hao-yue-1/SmartCar/README.md

# SmartCar
第十七届全国大学生智能车竞赛-四轮摄像头组

@autor: 

-   图像、控制、结构：**吴滨楠**、**刘骏帆**，

-   电路：**钟锐城**
