hao-yue-1/SmartCar/Seekfree_TC264_Opensource_Library/修改日志.md

# 2021/12/8 WBN

- main.c
  - 添加变量定义，修改格式
