hao-yue-1/SmartCar/(list of files, drawings)

Other design files:
Hardware/宝宝主板_V7/宝宝主板_V7.PrjPcb
Hardware/宝宝主板_V7/宝宝主板_V7.SchDoc
Hardware/宝宝驱动板_V8/宝宝驱动板_V8.PrjPcb
Hardware/宝宝驱动板_V8/宝宝驱动板_V8.SchDoc
