hao-yue-1/SmartCar/Seekfree_TC264_Opensource_Library/CODE/Motor.c

/*
 * Motor.c
 *
 *  Created on: 2021年12月19日
 *      Author: yue
 */

#include "Motor.h"
#include "Filter.h"         //滤波
#include <stdio.h>
#include "PID.h"            //PID
#include "SEEKFREE_18TFT.h"
#include "LED.h"

void Stop(void);

int16 speed_l,speed_r;      //电机左右速度目标值的全局变量
uint8 encoder_dis_flag=2;   //编码器测距flag（赋初值=2，避免自己开启检测导致int溢出）

/*
*********************************************************************************************************
** 函 数 名: MotorSetPWM
** 功能说明: 控制左右电机的转速与正反转
** 形    参: left_speed：赋值给左电机的转速
**           right_speed：赋值给电机的转速
** 返 回 值: 无
*********************************************************************************************************
*/
void MotorSetPWM(int pwm_l,int pwm_r)
{
    //限幅处理
    if(pwm_l>MOTOR_PWM_MAX)
        pwm_l=MOTOR_PWM_MAX;
    else if(pwm_l<-MOTOR_PWM_MAX)
        pwm_l=-MOTOR_PWM_MAX;
    if(pwm_r>MOTOR_PWM_MAX)
        pwm_r=MOTOR_PWM_MAX;
    else if(pwm_r<-MOTOR_PWM_MAX)
        pwm_r=-MOTOR_PWM_MAX;
    //判断电机的正反转并进行速度赋值
    //下面是逐飞驱动板，使用一个IO口控制正反转，一个IO口输出PWM的控制方式
//    if(pwm_l>=0)   //左电机正转
//    {
//        gpio_set(P02_6,0);
//        pwm_duty(LEFT_MOTOR_PIN1,pwm_l);
//    }
//    else                //左电机反转
//    {
//        gpio_set(P02_6,1);
//        pwm_duty(LEFT_MOTOR_PIN1,-pwm_l);
//    }
//    if(pwm_r>=0)  //右电机正转
//    {
//        gpio_set(P02_7,0);
//        pwm_duty(RIGHT_MOTOR_PIN1,pwm_r);
//    }
//    else                //右电机反转
//    {
//        gpio_set(P02_7,1);
//        pwm_duty(RIGHT_MOTOR_PIN1,-pwm_r);
//    }

    //下面是自制驱动板，使用两个PWM信号驱动一个电机的驱动方法
    //左电机
    if(pwm_l>=0)   //正转
    {
        pwm_duty(LEFT_MOTOR_PIN1,pwm_l);
        pwm_duty(LEFT_MOTOR_PIN2,0);
    }
    else                //反转
    {
        pwm_duty(LEFT_MOTOR_PIN1,0);
        pwm_duty(LEFT_MOTOR_PIN2,-pwm_l);
    }
    //右电机
    if(pwm_r>=0)  //正转
    {
        pwm_duty(RIGHT_MOTOR_PIN1,0);
        pwm_duty(RIGHT_MOTOR_PIN2,pwm_r);
    }
    else                //反转
    {
        pwm_duty(RIGHT_MOTOR_PIN1,-pwm_r);
        pwm_duty(RIGHT_MOTOR_PIN2,0);
    }
}

/*
*********************************************************************************************************
** 函 数 名: MotorEncoder
** 功能说明: 读取左右电机的编码器的值
** 形    参: left_encoder：左电机编码器的值
**           right_encoder：右电机编码器的值
** 返 回 值: 无
** 注    意：由于编码器相对放置，向前运动时对右编码器取反处理
*********************************************************************************************************
*/
void MotorEncoder(int16* left_encoder,int16* right_encoder)
{
    //左编码器
    *left_encoder = gpt12_get(LEFT_ENCODER);
    gpt12_clear(LEFT_ENCODER);
    //右编码器
    *right_encoder = -gpt12_get(RIGHT_ENCODER);
    gpt12_clear(RIGHT_ENCODER);
}

/*
*********************************************************************************************************
** 函 数 名: MotorCtrl
** 功能说明: 使用增量式PI控制器控制左右电机转速
** 形    参: speed_l：左电机速度
**           speed_r：右电机速度
** 返 回 值: 无
*********************************************************************************************************
*/
void MotorCtrl(int16 speed_l,int16 speed_r)
{
    int16 encoder_l=0,encoder_r=0;   //左右电机编码器值
    int pwm_l=0,pwm_r=0;             //左右电机PWM

    MotorEncoder(&encoder_l,&encoder_r);              //获取左右电机编码器
    encoder_l=SecondOrderLagFilter_L(encoder_l);      //低通滤波
    encoder_r=SecondOrderLagFilter_R(encoder_r);
    pwm_l=Speed_PI_Left(encoder_l,speed_l,MotorK_L);    //左右电机PID
    pwm_r=Speed_PI_Right(encoder_r,speed_r,MotorK_R);

    MotorSetPWM(pwm_l,pwm_r);                   //电机PWM赋值
    EncoderDistance(0,0,encoder_l,encoder_r);   //采集编码器值，用于编码器测距

//    //VOFA上位机调试
//    printf("%d,%d\n",encoder_l,encoder_r);  //发送左右编码器
}

/*
*********************************************************************************************************
** 函 数 名: MotorSetTarget
** 功能说明: 设置左右电机速度的目标值
** 形    参: target_l：左电机速度目标值
**           target_r：右电机速度目标值
** 返 回 值: 无
*********************************************************************************************************
*/
void MotorSetTarget(int16 target_l,int16 target_r)
{
    //速度限幅
    if(target_l>base_speed+SPEED_LIMIT)
    {
        target_l=base_speed+SPEED_LIMIT;
    }
    else if(target_l<base_speed-SPEED_LIMIT)
    {
        target_l=base_speed-SPEED_LIMIT;
    }
    if(target_r>base_speed+SPEED_LIMIT)
    {
        target_r=base_speed+SPEED_LIMIT;
    }
    else if(target_r<base_speed-SPEED_LIMIT)
    {
        target_r=base_speed-SPEED_LIMIT;
    }
    //速度赋值
    speed_l=target_l;
    speed_r=target_r;
}

/*
*********************************************************************************************************
** 函 数 名: EncoderDistance
** 功能说明: 编码器测距，该函数将在编码器中断中被调用于采集编码器的值（flag=0）；
**           在主进程中被调用于设置目标距离和开启检测，开启后需要用户手动查询encoder_dis_flag==1?
**           从而检测是否达到目标值
** 形    参: flag：选择函数功能（0：采集数据；1：测距模式；2：停车模式）
**           dis：目标距离，单位m（只有flag=1、2时，此项才起作用）
**           encoder_l：左编码器值（只有flag=0时，此项才起作用）
**           encoder_r：右编码器值（只有flag=0时，此项才起作用）
** 返 回 值: 无
*********************************************************************************************************
*/
void EncoderDistance(uint8 flag,float target_dis,int16 encoder_l,int16 encoder_r)
{
    static int encoder_nowsum=0,encoder_target=0;   //当前值和目标值
    static int stop_nowsum=0,stop_target=0;         //停车模式
    static uint8 encoder_stop_flag=0;               //停车flag

    if(flag==0) //采集数据
    {
        int16 encoder=(encoder_l+encoder_r)/2;  //左右编码器均值
        if(encoder_dis_flag==0) //测距模式
        {
            encoder_nowsum+=encoder;                //编码器累加
            if(encoder_nowsum>encoder_target)       //当前编码器超过目标值
            {
                encoder_dis_flag=1; //编码器测距flag置1
            }
        }
        if(encoder_stop_flag==1)//停车模式
        {
            stop_nowsum+=encoder;                   //编码器累加
            if(stop_nowsum>stop_target)             //当前编码器超过目标值
            {
                Stop(); //停车
            }
        }
    }
    else if(flag==1)     //测距模式
    {
        encoder_target=11731*target_dis;    //根据目标距离计算目标编码器值
        encoder_nowsum=0;                   //清空编码器累积值
        encoder_dis_flag=0;                 //编码器测距flag置0，开启编码器采集
    }
    else if(flag==2)    //停车模式
    {
        stop_target=11731*target_dis;
        stop_nowsum=0;
        encoder_stop_flag=1;    //开启定距停车
    }
}
