hao-yue-1/SmartCar/Seekfree_TC264_Opensource_Library/CODE/LED.h

/*
 * LED.h
 *
 *  Created on: 2022年5月23日
 *      Author: yue
 */

#ifndef CODE_LED_H_
#define CODE_LED_H_

//主控板LED颜色定义
#define LED_RED         P23_1
#define LED_YELLOW      P22_1
#define LED_WHITE       P22_2
#define LED_BLUE        P22_3
#define LED_GREEN       P21_2

void LEDInit(void);

#endif /* CODE_LED_H_ */
