hao-yue-1/SmartCar/Seekfree_TC264_Opensource_Library/CODE/Attitude.h

//
// Created by yue on 2022/5/11.
//

#ifndef ICM20602_ATTITUDE_H
#define ICM20602_ATTITUDE_H

#include "common.h"

typedef struct{ //四元数
    float q0;
    float q1;
    float q2;
    float q3;
}quaterInfo_t;

typedef struct{ //欧拉角
    float pitch;
    float roll;
    float yaw;
}eulerianAngles_t;

typedef struct  //陀螺仪校准值
{
    int16 x;
    int16 y;
    int16 z;
}GyroOffset;

extern float values[6];
extern eulerianAngles_t eulerAngle;

void GyroOffsetInit(void);
void IMUGetValues(float * values);
void IMU_quaterToEulerianAngles(void);

#endif //ICM20602_ATTITUDE_H
