hao-yue-1/SmartCar/(commit log)

2021-12-08 修改main.c添加了变量定义
2021-12-09 LJF测试了一下上次本地修改
2021-12-09 修改了MD文档
2021-12-09 新增Steer.c/.h舵机控制
2021-12-09 修改舵机引脚宏定义
2021-12-09 新增扫线到赛道外的判断
2021-12-10 添加PID文件（里面啥都没），添加对中线丢失的记录
2021-12-10 新增丢线记录
2021-12-10 LJF修改了一些小问题，比如舵机引脚在函数里面没改，和二维数组的访问不小心写错
2021-12-10 LJF把黑白代表的0和255改为宏定义，修改了二值化和扫线那里
2021-12-11 修改了主函数里面的摄像头图像交互模式
2021-12-11 使用了逐飞库的18TFT修改了cpu0_main
2021-12-19 添加了电机控制Motor.c/.h
2021-12-19 修改舵机中值与左右打死值
2021-12-22 添加了最小二乘法拟合回归方程求斜率
2021-12-23 修改了main
2021-12-23 修改了回归方程，发现之前的代码中，用于计算的X和Y搞反了，并且返回的是斜率倒数也就是误差，而不是斜率了，误差的正负代表了方向具体正负代表左右看舵机
2021-12-23 PID控制的初步编写，只有粗略的舵机位置式PID和舵机PID结构体的定义，疑惑的地方写在注释里面了
2021-12-26 添加了编码器在motor，PID中加入了对电机的增量式PI控制
2021-12-26 main中添加编码器的初始化
2022-01-16 回归方程求斜率的分子带错公式了，可能是因为修改别人代码的时候修改完求和那里没有修改下面
2022-01-16 发现分母也没改过来跟Z小璇的是一样但是他行列对应的XY是搞反了的
2022-01-17 增加了寻找左右下拐点的函数，拐点结构体，以及修改了一下扫线，让右边丢线的右线数组值赋值到最右边，便于找拐点，并且在数学上也合理
2022-01-17 添加了ImageSpecial文件，用于存放赛道特殊元素的判断，并在其中添加了起跑线识别函数，完成基本逻辑的编写
2022-01-18 增加了根据左右下拐点找寻三岔的上拐点
2022-01-18 IDE的配置文件而已
2022-01-18 新增两点之间的补线函数
2022-01-18 起跑线识别的收尾工作，并写了环岛识别的初始想法
2022-01-19 增加了三岔判断函数
2022-01-19 修改了一下找左右拐点的函数，并不是找数组的最大最小，而是变化的点
2022-01-19 补充环岛识别的代码，稍微修改一些变量和宏
2022-01-20 两种环岛入口识别的方法
2022-01-23 模糊PID的雏形写完了，还欠缺三个参数的实际论域的大小以及偏差实际论域大小，后期调参还是要先调好传统PID，再引入模糊PID，然后再去调节它的规则表,隶属度计算函数不知道是否有错误，使用的是三角形隶属度函数
2022-01-23 修改起跑线识别，主要是封装形式
2022-01-23 添加了查找上拐点函数
2022-01-29 修改扫线函数，并在main中测试了扫线函数
2022-02-06 修改二值化，扫线，将图像原点放回左上角
2022-02-07 测试一下赛道元素识别
2022-02-21 根据图像原点仍然在左上角检查了斜率函数，发现道理还是一样的，没有进行修改，只修改了返回时分子为0时即：倒数为无穷，所以返回tan89°的值
2022-02-22 增加谷底最小值算法，以及在赛道上测试了扫线函数效果不错，(下午4点谷底最小值有用，五点大津法好用，综上光线好用大津法不好用谷底),测试拐点函数时出错，程序卡死，或者找不到拐点无反应，已撤回下午修改部分
2022-02-24 修改了寻找左右下拐点的函数，starline>endline还是从下往上遍历数组
2022-02-24 修改了斜率函数，把矩阵模拟到第四象限，做了些许改变，尚未验证
2022-02-24 修改了寻找左右下拐点函数，并且验证成功，在赛道上成功找出左拐点并在LCD上显示
2022-02-25 修改了三岔上拐点的寻找，并且验证了上拐点的搜寻，修改了bug，bug的原因是由于图像原点修改回去了左上，但是代码没有得到相应修改
2022-02-25 修改了main.c文件，测试拐点给WBN看，同时找到了偶尔卡死的原因，就是别把描点的点放大
2022-02-25 修改了环岛识别并验证，修改扫线误差bug
2022-02-26 整理一下工程代码规范，测试斜率函数，修改了前瞻长度，因为早上光线大，所以人为把阈值加了20
2022-02-26 实现环岛入口的补线，修改补线函数
2022-02-26 添加了一个二值化算法
2022-02-27 测试了新的二值化方法
2022-02-27 完善环岛入口的判断
2022-02-27 修改了一下左右下拐点和三岔上拐点函数函数开始置零拐点，测试了三岔识别函数成功，修改了补线函数，K应该为浮点型否则精度缺失为0，指针索引应该为int所以添加了强制类型转化
2022-02-28 修改新加的二值化阈值计算的bug（还没测试）
2022-03-06 写了PID初始化函数，配合主控板修改了电机驱动引脚
2022-03-06 修改重定向的串口，改为蓝牙串口，串口2
2022-03-06 测试了电机驱动，编码器，和PI速度环
2022-03-06 “周日下午写完了蓝牙发送数据和蓝牙接收，使用串口2中断回调函数进行”
2022-03-07 蓝牙发送斜率偏差函数的编写，采集斜率的赛道数据得知，偏差一般为4.6左右测试的时候前瞻取的是整个屏幕中间的三分之一，尝试往前再取一点
2022-03-07 修改了下舵机PD控制，返回了-PWM+舵机中值的处理，但是PWM是无符号的，所以KP不能超过一个数字，估计为765/5
2022-03-09 蓝牙串口中断接收添加一些注释
2022-03-10 优化串口中断蓝牙接收数据代码
2022-03-13 增加了十字的识别，修改了寻找左右下拐点的函数（从下往上如果找到了就不再进行判断）,WBN修改了扫线时候丢线给的值为最大边界-1为了lcd不卡死，也修改了他的圆环条件-1
2022-03-13 修改了舵机pid
2022-03-13 十字和三岔一起进行判断，解决了三岔误判的情况，条件就是，三岔的左右拐点往上不会太快丢线
2022-03-13 增加了十字判断方法，正入情况和斜入情况都有
2022-03-13 修改识别十字函数
2022-03-14 添加新的电机驱动，添加新的求Bias，修改舵机PID
2022-03-15 修改PID、补线
2022-03-17 把三线设置为全局变量，extern在ImageBasic.h文件中，修改了三岔识别和十字识别函数，在识别完类型之后就进行补线
2022-03-18 修改了十字和三岔的误判，修了一下图像，三岔上顶点加了条件，车基本动了起来，直线很摆，可能偏差函数有问题，D加一点就不会超调
2022-03-18 添加滤波算法，添加舵机的PID算法，修改PID结构体
2022-03-18 修改了编码器的滤波滤去了十分大的尖峰和很小的个位数值，逐飞编码器返回的是定时器寄存器的值，所以放在轮询中会使得时间周期不统一而不是一个速度是位移
2022-03-18 速度环还是坏的，加i就超调到起飞，然后本来成功过一次，下午BN摆烂完把编码器放中断的时候，后面就寄了，9点开始调转向环成就不大，建议多去理论分析一下
2022-03-19 pid的参数修改为浮点型，在三个pid函数里面增加了计算pwm的时候强制类型转化为int
2022-03-19 解决速度环PID的BUG，注：先开驱动板再开主控板，防止主控板误判编码器的值累积PID误差
2022-03-19 微调速度环PID（没啥用）
2022-03-20 添加了野火上位机的通信协议，修改并添加了PID和MOTOR的全局变量
2022-03-20 添加停止电机的选项
2022-03-21 添加野火PID调试助手通信协议，添加环岛入口识别（静态验证，存在较多误判）
2022-03-21 添加了环岛入口的判断（仅环岛在左侧的情况），已低速验证不会存在误判
2022-03-22 舵机控制放在了中断中，舵机PWM设为全局变量，舵机PID值换成了上周那个，速度还是只有50,50走的真的很好，接下来可能要分段才能提速了
2022-03-23 把蓝牙调参的相关修改全删除，蓝牙串口回调函数
2022-03-23 在蓝牙串口中断中加入野火上位机的数据接收
2022-03-24 添加了三岔识别，如果左右拐点不存在，并且第一行就开始丢线的情况也去寻找上拐点存不存在，修改电机限幅为8300
2022-03-24 修改了电机PID的一个小问题
2022-03-25 修改了三岔左右怪点消失，只有V型的BUG，不以最下面一行丢线，而是倒数第十行否则会和普通弯道误判，不知道为什么；找拐点的时候左右遍历更远一点；初始化画面左右下角为补线点的时候，Y应该是最大的而不是0；三擦汗上顶点判断存在加上了Y因为X最开始就赋值了所以X一定存在；存在问题：顶点找到了但是可能补线有问题，还没解决，去开会了
2022-03-25 添加了车库识别，还没验证
2022-03-25 修改了无法补线问题：参数传错了，删除了调试用的代码，以及修改了一个小bug寻找V点的时候宏定义穿错了传成H了，改为W
2022-03-26 添加了环岛识别的整体函数，将Bias修改为全局变量，删除之前自己写的查找上拐点的函数
2022-03-26 重写了环岛识别
2022-03-27 验证新的环岛识别，出环岛还未完善
2022-03-27 完善环岛状态机，修改其中状态二的机制，除三岔S道外无其他误判
2022-03-28 添加编码器的滤波并调整了速度环PI，对环岛状态二的跳转加限制条件
2022-03-28 周日修改的三岔现在上传，做出的调整是在三岔补线之后就进行偏差计算，不在外面进行计算了，减少了一个上拐点存在的条件增快速度，验证良好
2022-03-28 修改了补线函数，让人为选择补左还是右
2022-03-29 添加了图像总处理的逻辑函数，目的是得到Bias给中断去控制
2022-03-29 修改了补线函数的bug
2022-03-29 修改了扫线的bug：120-1，修改了十字的bug，X改为Y
2022-03-30 完善环岛，主要是环岛中部的判断和进环岛后给一个补偿偏差
2022-03-30 完善三岔和十字，更新舵机PD为纯P
2022-04-02 修改了三岔和十字
2022-04-02 修改环岛状态机，修改元素判断优先级
2022-04-03 更新了逐飞的封装库
2022-04-04 没什么动作，但还是同步一下
2022-04-06 速度提到100，舵机P加了0.25，计算偏差加了个判断点是不是白点，否则不要，二维数组访问可能很慢，我认为可以在扫线加上标志位，环岛可能识别不到出口
2022-04-07 修改环岛状态机机制，修改图像处理中环岛的flag为静态变量
2022-04-07 添加了Bias计算后真值的判断，调试起跑线（还没完成）
2022-04-08 修改识别起跑线函数（未验证）
2022-04-09 修改了前几天出现的十字在圆环里面误判的bug，还未验证
2022-04-09 把斜入十字的判断删除，经常会判断为斜入，但是到时候又不会，BIAS如果遍历到黑点就break
2022-04-10 斜入的情况还是要判断的，但是不做出反应
2022-04-10 十字在弯道的误判修改了，加了个二值化图像滤波作用一般需要改进，入圆环那个弯会误判成3的十字最好修改一下，用sobel测试了一下，几个flag变成全局变量用于蓝牙查看
2022-04-11 修改电机驱动模块
2022-04-11 修改程序到可以完整跑一圈
2022-04-12 添加了按键检测模块，并在CPU0中初始化
2022-04-13 昨晚：修改PID和速度环
2022-04-13 放弃环岛修改的程序，修改了舵机D并添加滤波
2022-04-13 删掉一些不相干的东西，包括protocol中的点灯和之前写的十字回环
2022-04-14 添加右环岛状态机，修改两个环岛的函数定义，并修改目标速度为90、转向环PID
2022-04-15 添加十字回环出口的判断
2022-04-15 修改右环岛出口识别的bug
2022-04-15 修改了十字回环出口的BUG，并添加赛道的状态机
2022-04-15 修改三岔识别，将十字回环识别分为两个，添加入库
2022-04-15 完善状态机
2022-04-16 Bias再分一段加权，速度提到100
2022-04-16 加入差速转向，添加若干宏定义
2022-04-16 添加左库斑马线，和三岔修改
2022-04-16 添加十字入环判断
2022-04-16 添加了三岔函数的状态机，这样能够判断三岔结束
2022-04-16 完善整个赛道的状态机，修改识别十字回环入口的bug
2022-04-16 修改入库bug，降低速度90
2022-04-17 添加了第二个十字回环入口补线
2022-04-17 修改了斑马线左边
2022-04-17 90跑完一圈
2022-04-17 调了下左车库，100很虚，95比较稳
2022-04-17 添加出库，速度分段
2022-04-17 添加了左库识别状态机，一帧延迟防误判，速度能上105
2022-04-17 修改三岔状态机
2022-04-17 完善状态机，修改差速限幅
2022-04-17 第一个十字回环120，第二个十字回环也提速了，然后入第二个十字回环的时候D减小差速增大
2022-04-17 修改环岛状态机和十字回环出口
2022-04-17 烧板前还能跑的程序，把左环岛速度提高100，但是好像不是很稳定，出十字回环出口加了减速并调大差速，作用也不是很明显
2022-04-17 在1核中添加按键调，设定S5为退出调参，S1~S4具体功能未定
2022-04-18 完善按键调参的内容（未验证）
2022-04-18 添加按键调参，完善并验证
2022-04-18 修改十字回环
2022-04-18 取消分段控制参数的注释
2022-04-18 关闭了TFT，左车库上升到120，三岔上升到130，十字回环125，回来125，之前的D和差速全都删去了
2022-04-18 第一个十字回环上升到135比较稳定，但是怕出来会碰到路肩
2022-04-18 修改左环岛状态机，进行提速
2022-04-18 修改右环岛状态机，提速
2022-04-18 完善状态机，速度到了但不够稳定
2022-04-19 没调啥，左库车速从120上升到130，进第一次三岔降速成125比较稳定，出两个十字回环打死的延迟降低了100ms，现在基本125是能稳定完赛的
2022-04-19 把三岔判断还是改回去了，注意现在是在三岔调试模式，状态四开始
2022-04-20 左环速度提升到130，速度环PID的I从1.2降低到1
2022-04-20 添加卡尔曼滤波（没有用到），修改差速阈值
2022-04-20 1.72m的程序，三岔识别有问题，状态机出不去，准备放宽状态机先放宽状态机看看稳不稳定，再放宽三岔识别提速，左库前面的弯道加差速加速
2022-04-21 三岔状态机改变，速度上升到135感觉还能升，左库有危险
2022-04-21 速度环添加D，修改按键
2022-04-21 添加三岔状态机，提高第二个十字回环出来的速度
2022-04-21 完善环岛状态机，添加出环岛补线，约束左环岛出环条件
2022-04-22 修改十字回环减速方案，右边可行版本
2022-04-22 微调左环岛路径方案，出库提到150，上次push中添加了按键修改分段状态
2022-04-22 修改速度环PID
2022-04-23 三岔加长延时帧，三岔速度从130提到140，150也成功过，但是不知道后面为什么不行了，而且成功了好几遍，车体很抖
2022-04-23 从第二个十字回环里面出来加个延迟，之后再进行三岔判断，否则s弯中间会误判
2022-04-23 降低第二个十字速度，在三岔中提速
2022-04-24 1.78m，但是入库超出去了
2022-04-24 三岔的加速放后一点
2022-04-25 补线增加了特殊情况，三岔丢失左右下拐点那一帧bias*1.5，入第一次三岔速度提到160，但是没全程跑一遍
2022-04-25 添加环岛补线
2022-04-25 第二次入三岔的速度从150提到160,准备写个三岔正入跟随拐点行数去缩放bias的操作
2022-04-25 修改摄像头帧数，修改各部分延时对应，修改第二个十字回环出环速度
2022-04-25 大幅提速，25.3秒
2022-04-26 之前修改的摄像头帧数忘记上传
2022-04-26 修改左环岛状态机，入环不减速，两个十字回环入环速度提高
2022-04-26 调了下入库，发现根本不是入不了库，的被路肩弹开
2022-04-26 左环岛和左车库提速
2022-04-26 第一个三岔从155提速到165
2022-04-26 验证了十字回环回来，识别到三岔出口的减速少5，入库识别到打死前加10ms延时，入三岔中间之后KD从5减小到3
2022-04-26 出第一个十字回环延时减小
2022-04-27 添加阿克曼差速，修改舵机参数，修改右环岛补线，修改入库
2022-04-27 修改第二个十字回环入口补线
2022-04-27 修改第二个十字回环出环，修改速度
2022-05-16 修改车模机械结构，重新调整舵机中值等数据和阿克曼打角
2022-05-18 添加ICM20602模块和相应的姿态解算，其中yaw并不理想需要改进
2022-05-19 添加陀螺仪Z轴角度积分
2022-05-19 八领域写了左线寻找，打印出来看看效果如何，还没对八领域到的拐点进行处理
2022-05-21 找回十字识别，粗略写了十字的状态机，但是入十字途中的画面没写，后续再加一个新的找拐点函数
2022-05-23 补充之前ICM的遗漏，重新封装了一下LED和KEY
2022-05-24 修改了LED灯对应引脚的宏定义，完善了十字识别，现在补线补的还不错，左右斜入也OK了，但是发现了个问题，找拐点函数好像有问题，不动它一会坐标找得到一会找不到
2022-05-24 十字状态机调试，陀螺仪辅助出环还不错，但是不能完全转到270再识别出口要差不多270的时候就应该去识别出口了，识别出口只识别了一帧可能有点草率，打算再加点，ICM地址改为接地
2022-05-24 “简单优化一下之前的姿态解算 git commit -m“简单优化一下之前的姿态解算
2022-05-24 “改一下注释 git commit -m“改一下注释
2022-05-25 修改文件架构，把每个元素识别相关的源代码分开各自的源文件中，但是头文件还是一个special.h，已经分开了十字三岔车库
2022-05-25 修改图像识别函数.c文件的封装
2022-05-25 升级了一下补线函数，因为还没测试所以是另写了个V2新函数，如果验证还不错之后，可能会考虑替代掉之前的函数
2022-05-26 把入十字中的状态也写成一个else if写入十字识别中
2022-05-27 找拐点函数寻找的怪点更加精确了
2022-05-27 十字识别修改，改了下正入的判断，以及入十字中间，还有那个识别的else return 0纯纯编译器骗人
2022-05-28 添加陀螺仪零漂修复
2022-05-28 修改速度环为两个套参数
2022-05-28 十字微调，正入找上拐点的函数避免因为拐点处乱七八糟，起始点从拐点行的-5行增加到了-15行，斜入十字的条件增加了一边的丢线要小于一半，状态机有TFT和无TFT，以及出状态普通巡线均测试过，没问题，就是出状态的时候是十字中间，注意不要跟其他元素误判,出三岔那里会误判十字，下次再细看一下
2022-05-29 修改舵机PID和中值
2022-05-29 重写了左库识别函数，以及左库状态机，完善了左库入库或不入库都有，缺陷在于，斜率的放缩是盲调的，比如入库我觉得我补线也补的还行，但是它打角了我就缩小了点，然后丢失左拐点的时候补线会补的极端点，ICM判断入库，如果一开始角度不好很容易寄，后续考虑加上图像一起判断一下
2022-06-01 添加了寻找上拐点的函数，还没测试，有LCDdebug的代码在里面，一去工一马上就能看出行不行问题在哪，用法是找到下拐点之后根据下拐点给起始行
2022-06-01 调整环岛状态机
2022-06-02 修改舵机PID
2022-06-03 从上往下遍历左右线来找直角上拐点，起始行要小于结束行，在VS2019OPENCV中测试过能顺利运行只需要调试那两个宏定义即可
2022-06-03 把正入十字，以及左库的上拐点换成了新写的搜寻上拐点函数
2022-06-04 修改出环和入环
2022-06-04 添加压缩图像包括二值化，需要的时候把宏定义值改为1即可，简单测试过扫线和找拐点扫线范围改为一半，遍历段数改为一半即可
2022-06-04 修改环岛函数声明
2022-06-04 修改了点小BUG在opencv中发现的，确定是否要压缩的宏定义应该在头文件
2022-06-04 完善环岛（左）
2022-06-06 修改舵机频率
2022-06-06 十字封装了一下用那种方式找上拐点，最后还是决定用之前的遍历蓝布吧，上拐点的函数添加了多一个条件，防止因为扫线的问题使得拐点找错OPENCV测试正常实际运用不行，车库暂时看起来用找拐点方式是OK的,差值阈值改为30
2022-06-08 对称写完了右车库的代码，具体实现跟左库一样，封装了一下两种找上拐点方式的选择，在于车库中，暂时还是选用黑白跳变法
2022-06-12 修改了一下右边入库的一些BUG，还有左右不入库时的循迹偏差方式进行了修改，跑了一下右边车库的入库160是OK，180不行，但是还是能入，左边入库不行，左右不入库都可以180,对于不入库我在想是否是因为舵机频率改变PID作用小了，使得入不了库，实在不行打死吧，然后根据ICM作为判断是否入库成功
2022-06-12 左环岛跑到210
2022-06-12 微调左环岛遗留未发现的问题
2022-06-12 修改右环岛，各方面和左环岛匹配，但是还是存在大小环的问题，小环岛速度上不去，且判断环岛第一个flag1的地方有一个小bug待解决
2022-06-16 封装一下车库的代码规范，写了个打死入库，看起来效果一般，库确实能进去了，但是感觉跟停不下来一样，右库之前那样进不去了，好奇怪，在考虑是不是Sobel太慢了或者控制在作祟，优化了下不入库的循迹标准，做了个下拐点是否存在的判断，左边感觉如果不是控制参数不好200+不入库还是能上去的，直角弯过不去了，230的时候，左边普通入库比打死入库还好的感觉，因为最后在测试不入库的时候用错接口了测试180的时候入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
2022-07-09 三岔找拐点左右搜白的距离封装成宏定义方便以后修改，压缩后识别函数也要进行对应修改，改了下注释
2022-07-09 初步搭建左十字回环状态机，无验证
2022-07-09 修改了三岔的补线，修改了斜入时候确定上拐点的起始X，封装了下，增加了个拐点固定宽度，这个是调试的时候应该要调的
2022-07-09 添加Over函数
2022-07-10 替换舵机为S3010，修改舵机左右中值，修改舵机的PID
2022-07-10 三岔修改一下宏定义，试跑了一下识别函数和状态机，200没问题
2022-07-10 完善十字回环出环
2022-07-10 往上再往中间根据图像黑白跳变找上拐点封装成一个函数，修改了车库识别函数
2022-07-10 修改了不入库时候的循迹偏差的行，封装了下DEBUG函数
2022-07-11 添加编码器测距函数，未测试
2022-07-11 完善测距函数，以验证
2022-07-11 修改舵机偏转值参数
2022-07-11 Baic增加了测赛道宽度函数，测试的时候蓝牙发送即可（如果单边巡线好用考虑写进EEPROM，MCU再从EEPROM读取），Track增加了单边巡线函数，但是跑起来似乎没什么效果
2022-07-11 完善左十字回环，可以跑到200
2022-07-11 左环岛的草稿
2022-07-11 三岔220
2022-07-11 添加左环岛中部判断，未验证
2022-07-11 添加右十字回环函数，未验证
2022-07-12 修复一些bug
2022-07-12 验证左环入环函数
2022-07-12 三岔条件加了个括号，左库240
2022-07-12 修改入环补线算法，达到手动补线的效果
2022-07-12 修改环岛中部识别函数，还是有一些bug
2022-07-12 不入库贴多了一条斑马线，测试了250也可以，入库入不进去track修改了单边巡线，最后发现根本没用，只有对直道才有用，入库180的速度，会有几个奇怪现象：中间降速到100的时候就停下来了然后复位，进去之后没即使停下马上出去了又
2022-07-12 修改右库索贝尔阈值
2022-07-13 优化环岛中部的判断
2022-07-13 优化环岛中部的判断V2
2022-07-13 衔接入环全过程，200
2022-07-13 修改了索贝尔检测的接口
2022-07-13 把有关索贝尔的宏定义放进了车库的c文件
2022-07-13 修改了车库的一些索贝尔范围，阈值，还有不入库的适合索贝尔检测到了之后前瞻改到绝对不可能是车库地方的范围，250跑的更加直了，入库停不下来，怀疑是反转的时候不给力，-180到0，会有静差，会不会是启动的时候静差没被消除呢？
2022-07-13 修改出环函数，200
2022-07-13 修改舵机打死值
2022-07-13 完善左环岛，200
2022-07-13 优化出环识别补线，优化状态机结构
2022-07-14 完善验证右十字回环，和左十字同步200
2022-07-14 修改阿克曼遗留问题
2022-07-14 修改Stop（摆烂）
2022-07-14 重写三岔，在左右找不到白区域的时候，有一边找不到则进入种子寻找，耗时不大，一次识别才40us
2022-07-15 添加头文件，修改环岛入环识别，右环存在问题
2022-07-15 修改三岔的种子生长（推箱子）的一些缺陷，并且开启种子生长的条件也改了，图像补的还不错，但是速度还是220，200是一定能跑
2022-07-15 优化基础扫线方案，修改求Bias函数的定义
2022-07-15 修改了Basic文件的int->uint8，补线可以补垂直，return放错地方了
2022-07-15 修改Tack同Basic
2022-07-15 把uint8改回int
2022-07-15 修改LED宏定义，Main中添加头文件
2022-07-15 三岔修改了点BUG，对于偏差的if判断好像没起左右，明天看一下，只跑了210
2022-07-15 优化环岛补线直行的两个函数
2022-07-16 修改右环岛和左环岛同步
2022-07-16 优化左右环岛补线，目前只剩下两个直行的补线在某些地方比较丑，其他都还行，下一步应该是优化补线后的Bias
2022-07-16 三岔Bias做了处理，以及修改了一下两个拐点丢失的时候的一个特殊处理，重新补线，还需要解决的问题是出三岔进圆环那里的误判
2022-07-16 更换电池后优化Stop函数
2022-07-17 微调Stop函数
2022-07-17 三岔，修改BIAS，正入右斜入，消失两个拐点，增加了补折线的做法，使得循迹偏差不失真，修改了因为最终的BIAS行能到折线终点行，而不是上拐点速度220
2022-07-17 修改右环岛入环Bias计算
2022-07-17 修改按键定义
2022-07-17 添加OLED驱动
2022-07-17 添加按键PID调参
2022-07-17 Tack增加车库专用求偏差函数，左库不入库增加了一些丢线阈值去限制索贝尔开启，对于出三岔那个直角弯有BUG可能，入库打算重开一个源文件写,写好了再整理现在的车库源文件
2022-07-17 修改右环岛状态机：0状态的跳转
2022-07-18 左右环岛修尾工作完成，修改测距停车为测距和停车两种功能可同时使用
2022-07-18 优化左右十字回环出环补线方案，删除环岛多余两个函数
2022-07-18 重写了右车库入库，配合陀螺仪是能挺好的入库成功的，停不下来
2022-07-18 重新优化右十字回环出环补线，增加根据两点直线求第三点的函数
2022-07-19 优化左十字回环出环补线与右环同步
2022-07-19 右边入库试了另外种方案，比较稳定，但是总的来说大同小异的效果，增加了一条补线防止压脚，Basic修改了遍历数组找上拐点的条件，打算换一边入库
2022-07-19 优化两个状态机
2022-07-19 试了下右车库不入库240，在拐弯处慢了点，可能是因为第二次索贝尔的原因
2022-07-19 下午写右库的时候，把一些宏定义移到源文件里面
2022-07-19 修改舵机阈值和阿克曼计算
2022-07-19 修改左环岛Exit判断
2022-07-20 优化左右环岛出环补线和状态机跳转，简单搭建状态机
2022-07-20 左车库入库识别补线函数以及状态机，速度快就进不去
2022-07-20 优化Stop
2022-07-20 车库入库角度改为50°
2022-07-20 修改三岔之前遗留的种子BUG，粗略写了三岔状态机，还未验证
2022-07-20 修改速度环PID和Stop
2022-07-20 补充最终状态机，车库停车的状态机不在里面stop在外面stop，还未测试
2022-07-20 修改三岔状态机200能跑的很不错，串着右不入库跑了变，停的也及时，就在三岔出口，坡道的数编码器可能还要细调
2022-07-21 三岔修改为走右边，跑了220，跑的挺好
2022-07-21 编写三岔状态机,调整坡道拜纳姆其测距距离
2022-07-21 十字回环和右车库连起来，修改了右车库识别函数的一些BUG，和状态机BUG，主状态机加上了从出车库到三岔前的数编码器距离
2022-07-21 第一遍三岔的状态机进行修改，直道加速10，总状态机从车库出来那里数编码器的代码规范发生一点改变
2022-07-21 状态机流水灯，三岔对种子生长出来的点进行一个左右找白的再次检验，并没有把误判消除，我不理解，车库不接受下拐点下面的BIAS用上拐点上面的BIAS，并且修改斑马线处找到拐点的误判，以及上拐点不能在左上区域，防止看到三岔从而出界，三岔状态机增加出三岔数0.5m延迟保护，三岔状态机可以跑到220的基础速度，没试过再快
2022-07-22 添加调试状态机的按键调参
2022-07-22 修改第一遍三岔状态机，把出三岔的编码器改为用陀螺仪标定30度再检测到识别不到三岔即为出了三岔
2022-07-22 修改第二遍三岔的出状态机判定，改为陀螺仪判定，现在入口我也打算用陀螺仪，但是当务之急我先去看车库的BUG了，修完车库再来修三岔
2022-07-22 优化了一下索贝尔，现在索贝尔的时间变为1ms左右，状态机的转角改为了40度
2022-07-22 添加图像调参按键框架（未完成）
2022-07-22 添加了环内求Bias函数，优化右环入环
2022-07-22 修改十字回环和环岛的环内寻迹为特殊Bias情况
2022-07-22 优化左右环岛入环
2022-07-22 添加了从左环出来到识别三岔之前的陀螺仪延迟开启三岔识别
2022-07-22 添加单独.c文件写了入库状态机，存在的问题是有时候会拐不入车库，需要再细化补线入库
2022-07-23 修改入库方案为减速入库
2022-07-23 入库状态机的完善和更换
2022-07-23 LJF版本左库入库状态机改为以车库拐点的行作为停车条件，跑了几变还行，加入了当识别函数没识别到就打死的防止没入库，还没测试
2022-07-23 修改KeyProcess的一个bug
2022-07-23 右车库状态机改变
2022-07-23 优化左右环岛出环补线
2022-07-23 增加右车库斜入补线
2022-07-23 右车库补线函数的声明
2022-07-23 添加了出库函数
2022-07-23 完善KeyImage
2022-07-23 添加图像DEBUG模式
2022-07-24 添加了车库专属扫线函数
2022-07-24 添加了车库专属扫线函数，避免斑马线刚柔啊
2022-07-24 重写了右车库不入库补线函数，左线100行时不做处理，斑马线下来到90~50
2022-07-24 优化入库停车
2022-07-24 添加比赛时用的分段调速函数
2022-07-24 第二遍三岔用静态局部变量存储进三岔的速度方便下坡还原
2022-08-01 最后的省赛版本
2022-08-11 修改前瞻、Bias计算中取消放大区域
2022-08-12 补充修改speed的数据类型，添加一点注释
2022-08-12 替换求Bias函数，修改舵机PID
2022-08-12 发现之前一写的一个BUG，右车库爬谷底的时候，endline不应该以右拐点-15，应该更低点，否则变成三岔那样判断不到，打印了bias发现没有问题不会出现NAN
2022-08-13 修改转向环参数为Bias+Slope进行数据融合，修改求Slope函数，添加一个低通滤波
2022-08-13 添加按键修改舵机打角函数
2022-08-13 修改舵机中值
2022-08-13 修改右入三岔Bias结合斜率，跑了260的状态机还是不错，在三岔里面仅对其实结束行修改，所以使用时process记得把fork_flag去掉
2022-08-13 三岔在函数里面仅修改起始结束行
2022-08-13 修改完左入三岔的Bias，未测试，因为现在不打算走左边，只是为了以防万一要用要修改Bias的格式流程判断不太好
2022-08-13 调试三岔的一些东西删除，保持云端代码干净
2022-08-13 修改右环岛环中求Bias的问题
2022-08-14 修改左环和右环同步
2022-08-14 修改舵机中值，修改阿克曼差速
2022-08-14 求斜率的前瞻太前跳出endline行赋值进行bug修正
2022-08-14 endline=i不应该+1，+1之后求平均就少了一行
2022-08-14 舵机中值有误，作出修改
2022-08-14 修改三岔种子生长的阈值判断希望减少误判，以及再次验证的行进行修改，防止误判，修改种子生长的tempseed赋值条件（右边爬的时候发现的bug）
2022-08-15 恢复找拐点时候的种子生长，修改找到上拐点之后的再次误判，以防是三岔确没有被判断到
2022-08-15 优化OverBegin
2022-08-15 优化十字回环入环和状态机
2022-08-15 修改主状态机中关于十字回环的函数
2022-08-15 优化十字回环部分，添加重启状态机的功能
2022-08-15 优化环岛状态机，添加状态机重启功能
2022-08-16 修改二次补线的做法，使用八邻域再次给拐点上到前瞻结束行进行扫线，偏差的行数的修改选择注释了暂时没什么问题，状态机的加减速可以再做细致一点，这样有时候还没完全进去就加速了不知道好不好
2022-08-16 修改出环补线条件（适配前瞻），同步左右环的OverBegin
2022-08-16 优化入环补线，消除远处赛道干扰
2022-08-16 把状态机用状态标志位数组封装一下，修改数组即可以修改状态机
2022-08-16 修改Exit处补线前瞻适配
2022-08-17 优化按键响应
2022-08-17 修改十字路口的识别补线函数
2022-08-17 添加Exit处防误判
2022-08-17 修改差速
2022-08-17 添加Begin处防误判
2022-08-18 修改十字状态机
2022-08-18 修改总状态机状态选择函数，完善十字路口的状态机
2022-08-18 修改总状态机bug
2022-08-18 process删了忘记删的
2022-08-18 左边十字回环用正常扫线方式
2022-08-18 添加速度调参和编码器调参按键
2022-08-19 修改添加两个调参按键后的Bug
2022-08-19 添加出库后的速度修改
2022-08-19 车库直行封装成状态机
2022-08-19 车库直行状态机
2022-08-19 右车库直行状态机偏差斜率做处理，选择左半宽补线
2022-08-19 优化按键显示
2022-08-19 修改数据融合方式
2022-08-21 修改状态机为总决赛赛道
2022-08-21 恢复70-50的前瞻，避免混乱
2022-09-19 Add files via upload
    主控板、驱动板
    [宝宝主板_V7.PrjPcb, 宝宝主板_V7.SchDoc, 宝宝驱动板_V8.PrjPcb, 宝宝驱动板_V8.SchDoc]
2022-10-30 添加作者
