hao-yue-1/SmartCar/(notices)

Notices in the files:
Seekfree_TC264_Opensource_Library/USER/isr.c:
Copyright (c) 2020,Öð·É¿Æ¼¼
All rights reserved.
Seekfree_TC264_Opensource_Library/CODE/myiic.c:
Copyright(C) ¹ãÖÝÊÐÐÇÒíµç×Ó¿Æ¼¼ÓÐÏÞ¹«Ë¾ 2014-2024
